hegeduspeter02/LoraReceiver/schematics/Architecture.png

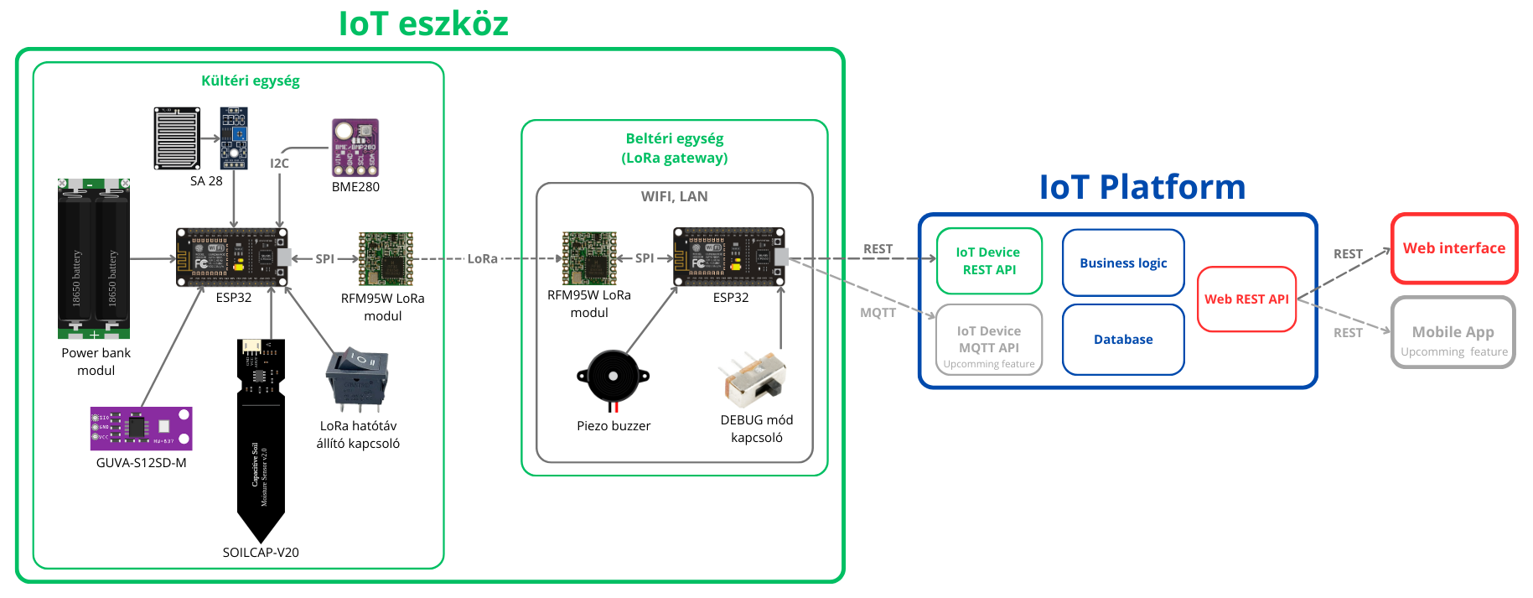
schematics/Architecture.png
