hegeduspeter02/LoraReceiver/schematics/LoraReceiver_flow_diagram.png

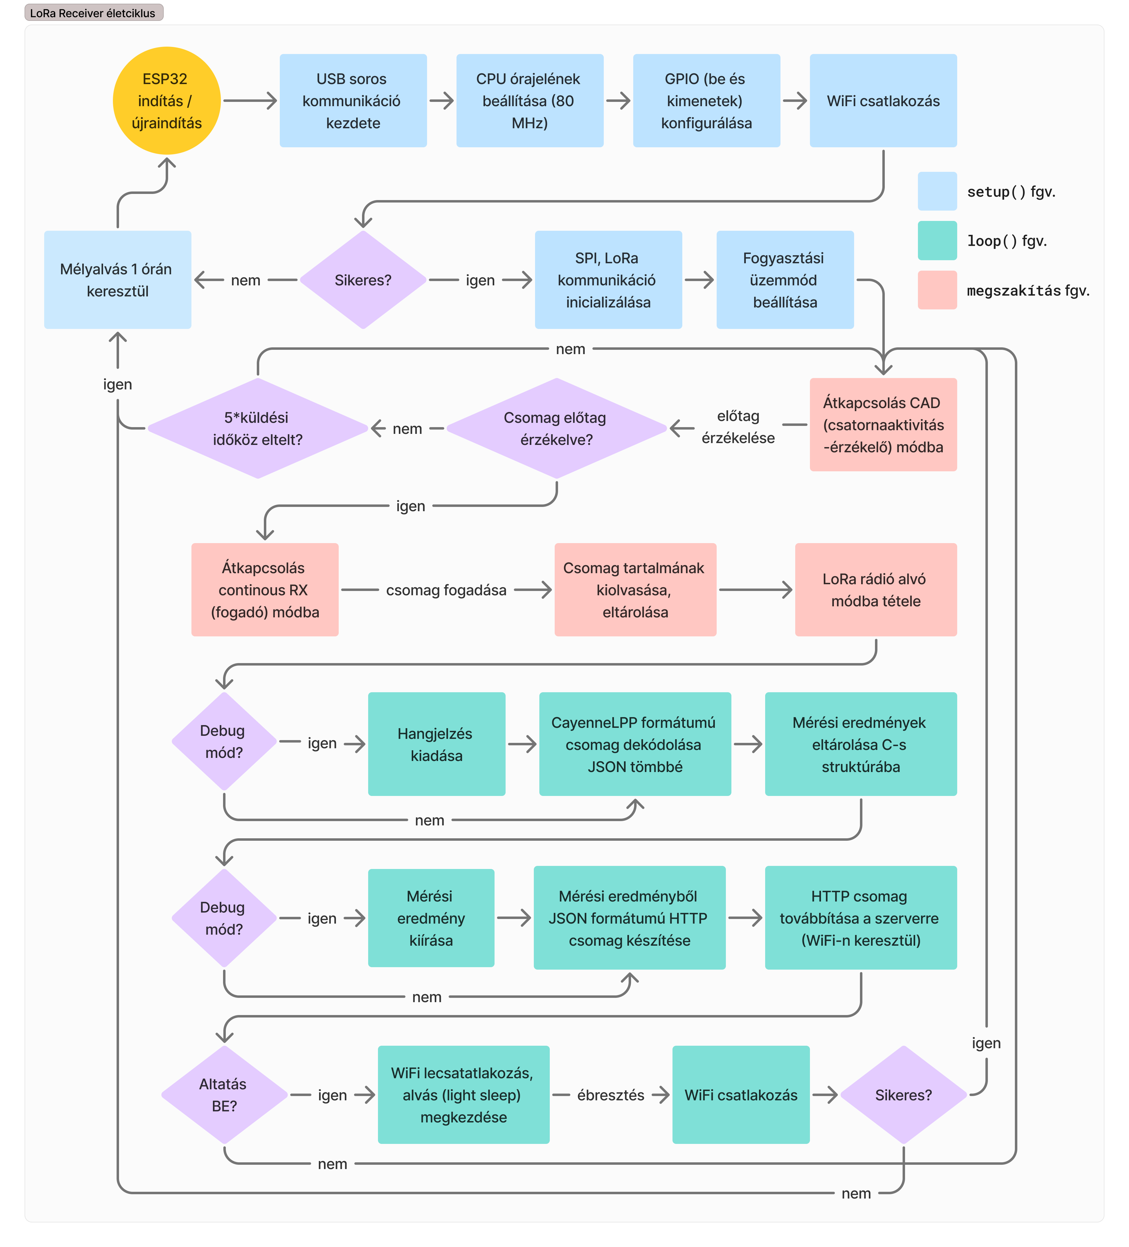
schematics/LoraReceiver_flow_diagram.png
