hegeduspeter02/LoraReceiver/schematics/LoraReceiver_prototype_board_vs_fritzing.jpg

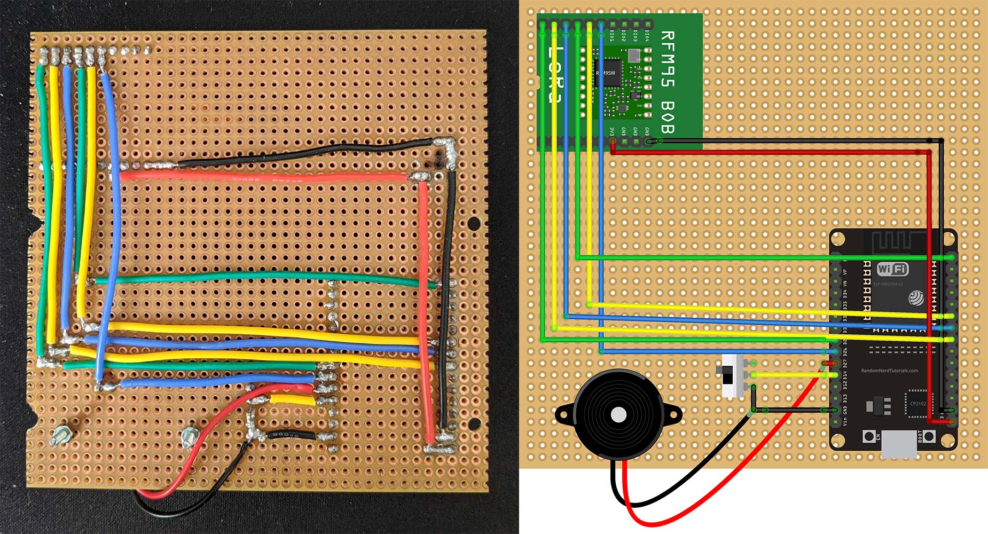
schematics/LoraReceiver_prototype_board_vs_fritzing.jpg
