hegeduspeter02/LoraReceiver/schematics/Schematics.pdf

SOILCAP-V20 | BME280 modul

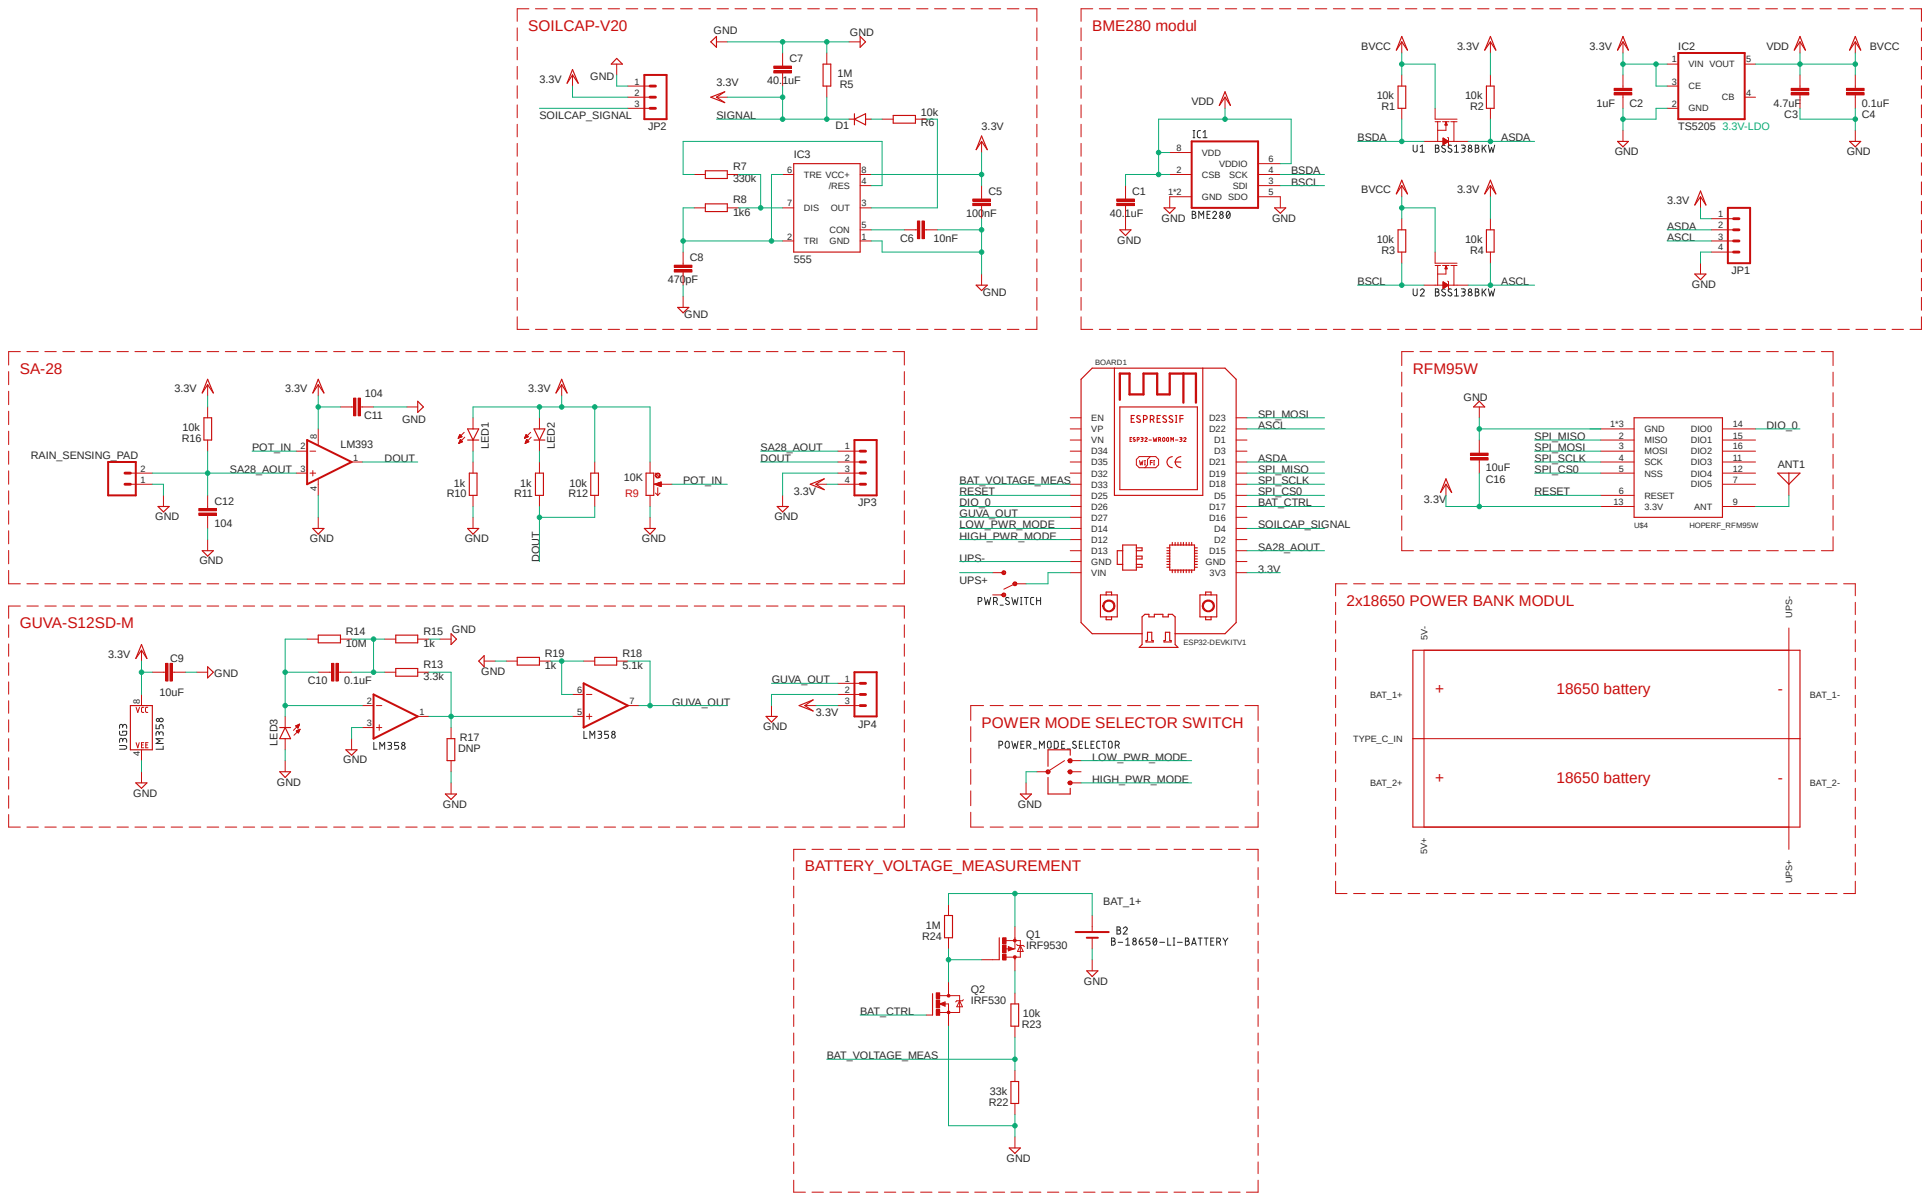
[picture p5: page 1]

-- 18650 battery

POWER MODE SELECTOR SWITCH

+ 18650 battery
