hegeduspeter02/LoraReceiver/(commit log)

2025-02-18 sleep and receive mode works and fix comments
    [LoraReceiver.h, LoraReceiver.ino]
2025-02-21 fixes for implement deep sleep if inactivity
    [LoraReceiver.cpp, LoraReceiver.h]
2025-03-10 debug mode switch check added
2025-03-10 changed pinMode on debug mode pin
2025-04-18 refactor: change packetSNR type from int8_t to float and update print function to include SNR
2025-04-21 refactor: update LoRa parameters for different power modes and clean up received payload handling
2025-04-22 refactor: define POWER_MODE and update LoRa parameter settings to use it
2025-04-25 refactor: update RFM95 send rate and sleep time factor for improved power management
2025-05-08 refactor: update LoRa handling for improved power management and code clarity
2025-05-08 feat: add LoraReceiver flow diagram to schematics
2025-05-11 feat: add prototype board vs Fritzing receiver diagram to schematics
2025-05-12 feat: add images of prototype and top-down view to README and schematics
2025-05-12 fix: adjust image size for prototype in README
2025-05-12 fix: remove width attribute from prototype image in README
2025-05-12 fix: remove LoraReceiver top-down view image from schematics
2025-05-12 feat: add LoraReceiver top-down view image to schematics
